mangdangroboticsclub/md300-bam-rig/hardware/coaxial_anchor/V2_Motor_Holder_Bottom.STL

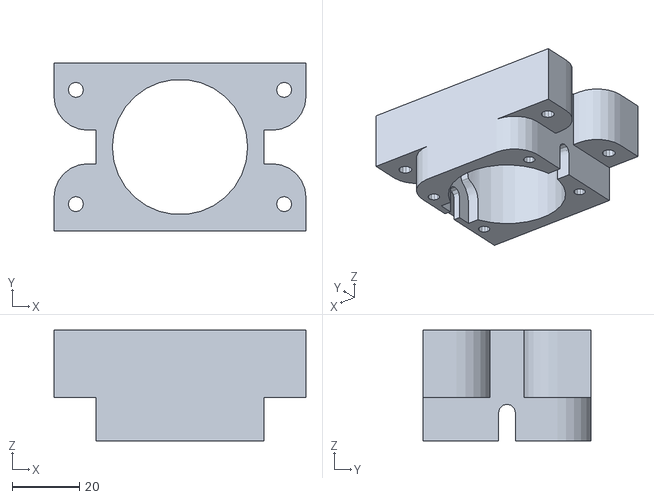
[picture p2: CAD file, 2026-11-09]
hardware/coaxial_anchor/V2_Motor_Holder_Bottom.STL
75.0 x 50.0 x 33.0
