mangdangroboticsclub/md300-bam-rig/hardware/pendulum/15cm_arm.STL

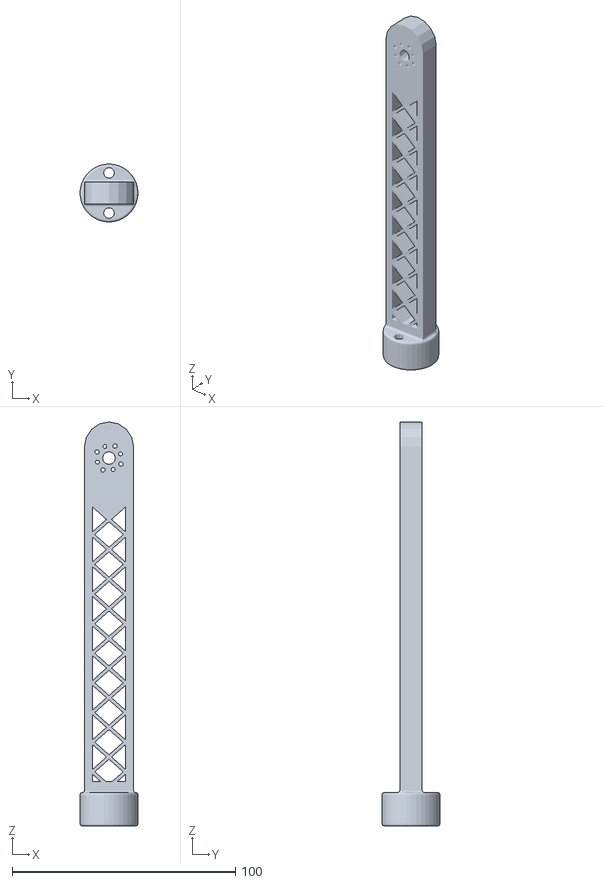
[picture p3: CAD file, 2026-11-09]
hardware/pendulum/15cm_arm.STL
26.0 x 26.0 x 181.2
