mangdangroboticsclub/md300-bam-rig/hardware/side_anchor/V2_back_portion_holder.STL

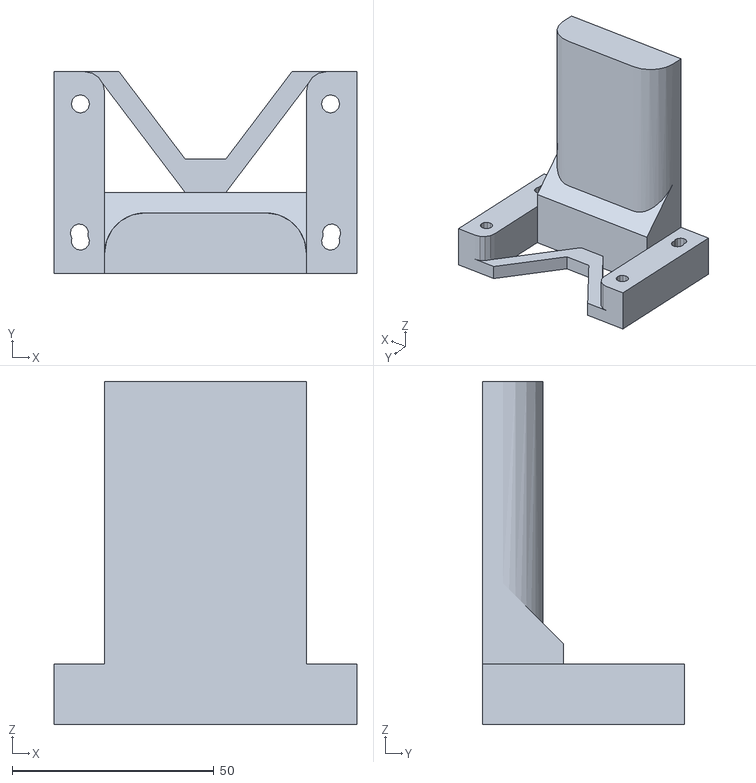
[picture p4: CAD file, 2026-11-09]
hardware/side_anchor/V2_back_portion_holder.STL
75.0 x 50.0 x 85.0
