mangdangroboticsclub/md300-bam-rig/hardware/pendulum/10cm_arm.STL

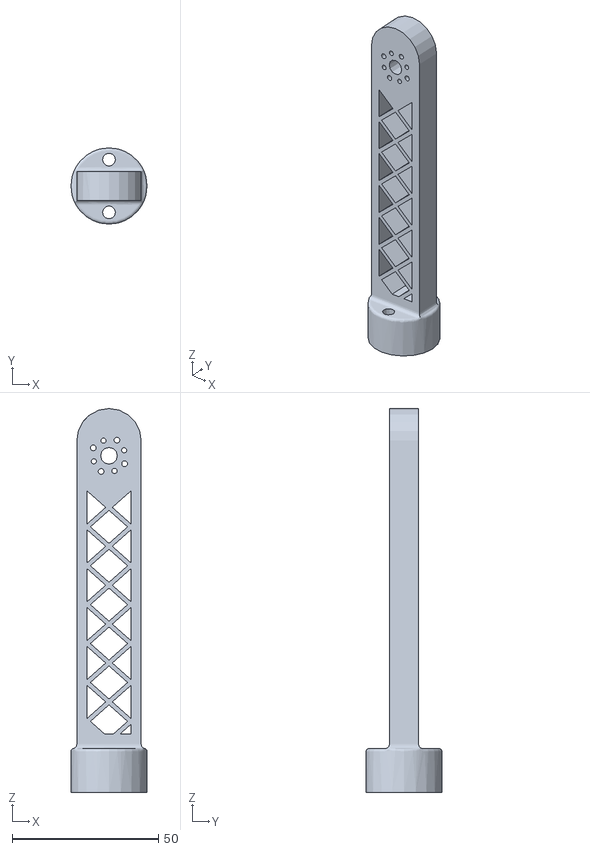
[picture p6: CAD file, 2026-11-09]
hardware/pendulum/10cm_arm.STL
26.0 x 26.0 x 131.2
