mangdangroboticsclub/md300-bam-rig/hardware/side_anchor/side_anchor_holder.STL

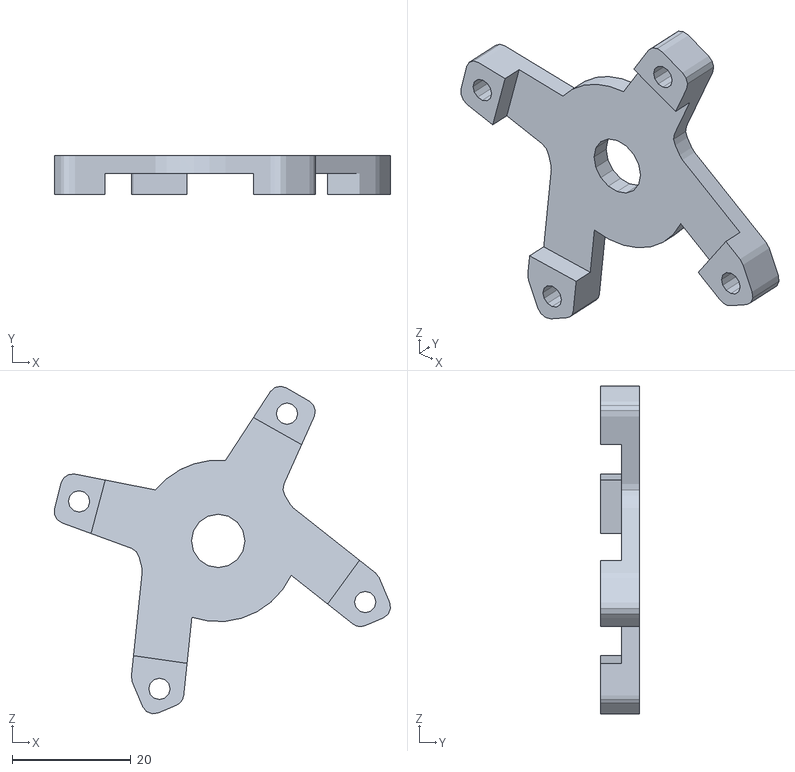
[picture p7: CAD file, 2026-11-09]
hardware/side_anchor/side_anchor_holder.STL
56.6 x 6.50 x 55.2
