mangdangroboticsclub/md300-bam-rig/hardware/coaxial_anchor/smooth_piece_motor_holder.STL

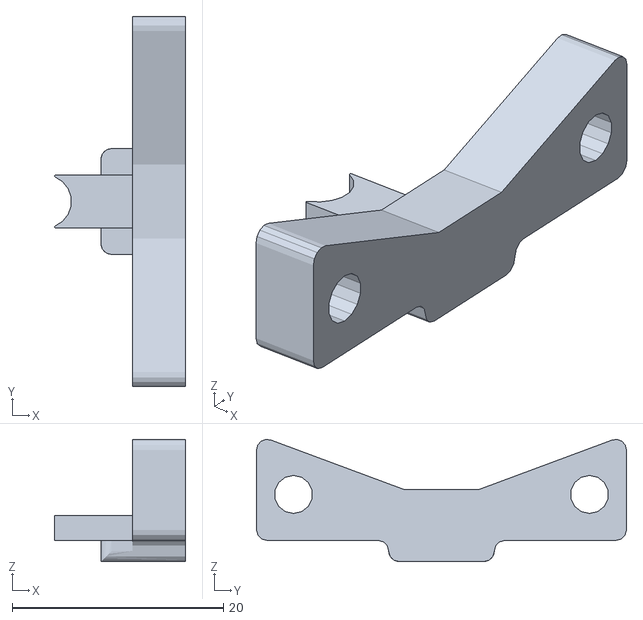
[picture p8: CAD file, 2026-11-09]
hardware/coaxial_anchor/smooth_piece_motor_holder.STL
12.4 x 35.0 x 11.6
