mangdangroboticsclub/md300-bam-rig/hardware/pendulum/12_5cm_arm.STL

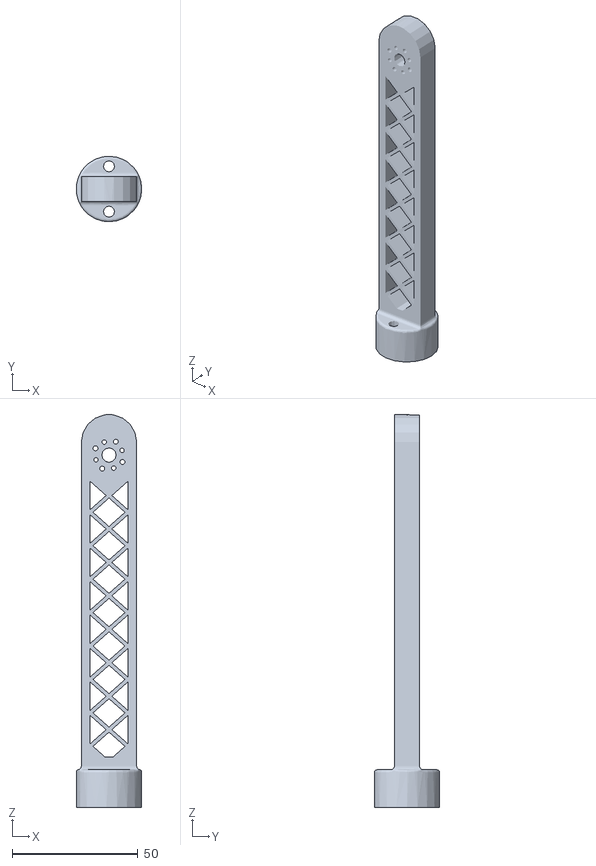
[picture p9: CAD file, 2026-11-09]
hardware/pendulum/12_5cm_arm.STL
26.0 x 26.0 x 156.1
