mangdangroboticsclub/md300-bam-rig/hardware/side_anchor/side_anchor_housing.STL

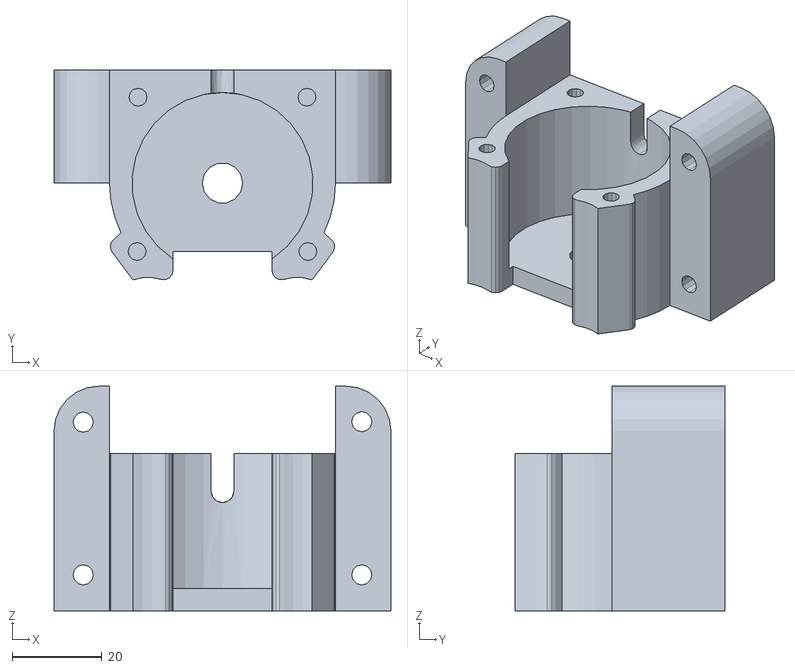
[picture p10: CAD file, 2026-11-09]
hardware/side_anchor/side_anchor_housing.STL
75.0 x 46.7 x 50.0
