mangdangroboticsclub/md300-bam-rig/hardware/pendulum/payload_bed.stl

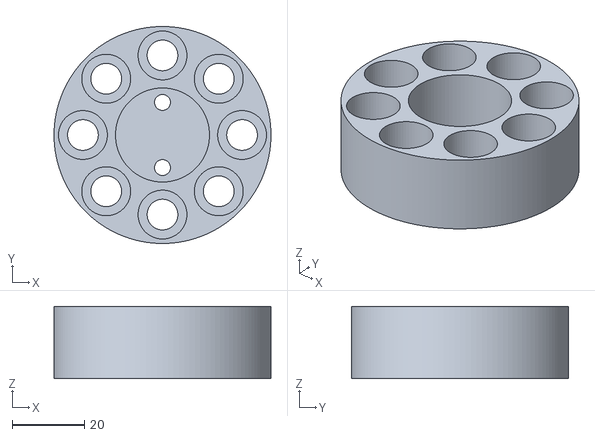
[picture p11: CAD file, 2026-11-09]
hardware/pendulum/payload_bed.stl
60.0 x 60.0 x 20.0
