mangdangroboticsclub/md300-bam-rig/(list of files, cad)

Other CAD files:
hardware/coaxial_anchor/V2_back_portion_holder.STL
