mangdangroboticsclub/md300-bam-rig/(commit log)

2026-11-09 Add the MD-300-150 BAM identification rig: printed parts, bridge firmware, README and BOM
    [10cm_arm.STL, 12_5cm_arm.STL, 15cm_arm.STL, V2_Motor_Holder_Bottom.STL, V2_back_portion_holder.STL, geared_piece_motor_holder.STL, payload_bed.stl, side_anchor_holder.STL]
2026-11-09 BOM: fasteners and parts
2026-11-09 Add a photo of the assembled rig
